cese-dci/tpfinal-dci-21b-Gonzagds/doc/propuesta/ESP PROG reverso.jpg

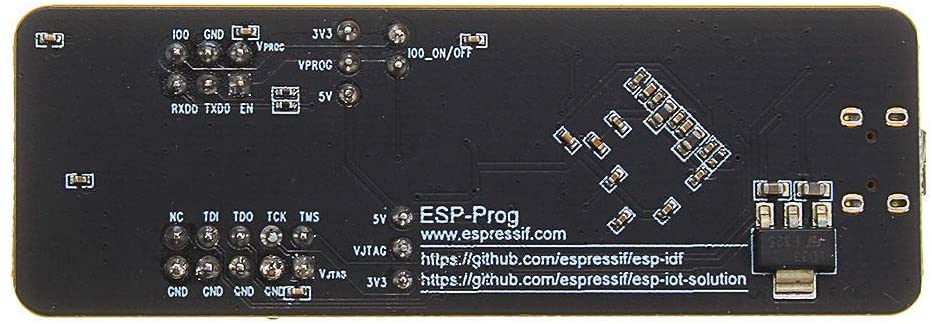
doc/propuesta/ESP PROG reverso.jpg
