cese-dci/tpfinal-dci-21b-Gonzagds/info/README.md

USB Interface IC USB HS to Dual UART/ FIFO/SPI/JTAG/I2C
http://www.ftdichip.com/Support/Documents/DataSheets/ICs/DS_FT2232H.pdf

Micro USB connector
https://ar.mouser.com/datasheet/2/670/uj2_mibh_g_smt_tr-2306717.pdf

Linear voltage regulator 3v3
http://www.st.com/st-web-ui/static/active/en/resource/technical/document/datasheet/CD00000544.pdf

Serial EEPROM Memory
http://www.st.com/st-web-ui/static/active/en/resource/technical/document/datasheet/CD00001142.pdf

Buffer driver
https://assets.nexperia.com/documents/data-sheet/74AHC_AHCT125.pdf

Inverting buffer
https://www.mouser.se/datasheet/2/308/mc74vhc1gt04-d-1193455.pdf

## Información complementaria ##
Para el alcance del TP solo es necesario colocar las hojas de datos más relevantes que se usaron en el diseño de PCB.
Pero el alumno puede completarlo tanto como desee.
