cese-dci/tpfinal-dci-21b-Gonzagds/doc/propuesta/README.md

https://docs.espressif.com/projects/espressif-esp-iot-solution/en/latest/hw-reference/ESP-Prog_guide.html

https://www.espressif.com/sites/default/files/documentation/ESP-Prog_V2.1_reference_design_r1.0.zip

https://media.digikey.com/pdf/Data%20Sheets/Espressif%20PDFs/Intro_to_the_ESP-Prog_Brd_Web.pdf

El Esp Prog es un grabador y debbuger para los devkit y modulos de la empresa Espressif. Se conecta a la PC mediante USB y cuenta con:
- Interfaz RS232 TTL para grabar la imagen y enviar y recibir mensajes de consola.
- Interfaz JTAG para debuggear paso a paso el programa.

## Propuesta ##
En este directorio debe ir OBLIGATORIAMENTE la información que se presentó al momento de acordar la propuesta de TP con el docente. Es decir:
* Fotos e imágenes de las placas de ambos lados si es una réplica. 
* Fotos e imágenes de los prototipos cableados o pruebas si es un trabajo de tesis.
* Urls o info de origen. 
* Circuito esquemático de referencia (si es una réplica) o borrador si es un trabajo de tesis.
* Resumen de la función u objetivo del circuito si es un trabajo de tesis.
* Cualquier otra nota que se haya usado para definir el TP en el formulario de propuesta.
