cese-dci/tpfinal-dci-21b-Gonzagds/doc/README.md

## Documentación ##
Para el alcance del TP solo es obligatorio completar el subdirectorio de "propuesta".
