cese-dci/tpfinal-dci-21b-Gonzagds/pcb/ESP-Prog.kicad_pcb

## KiCad design pcb/ESP-Prog.kicad_pcb (2021-08-21)

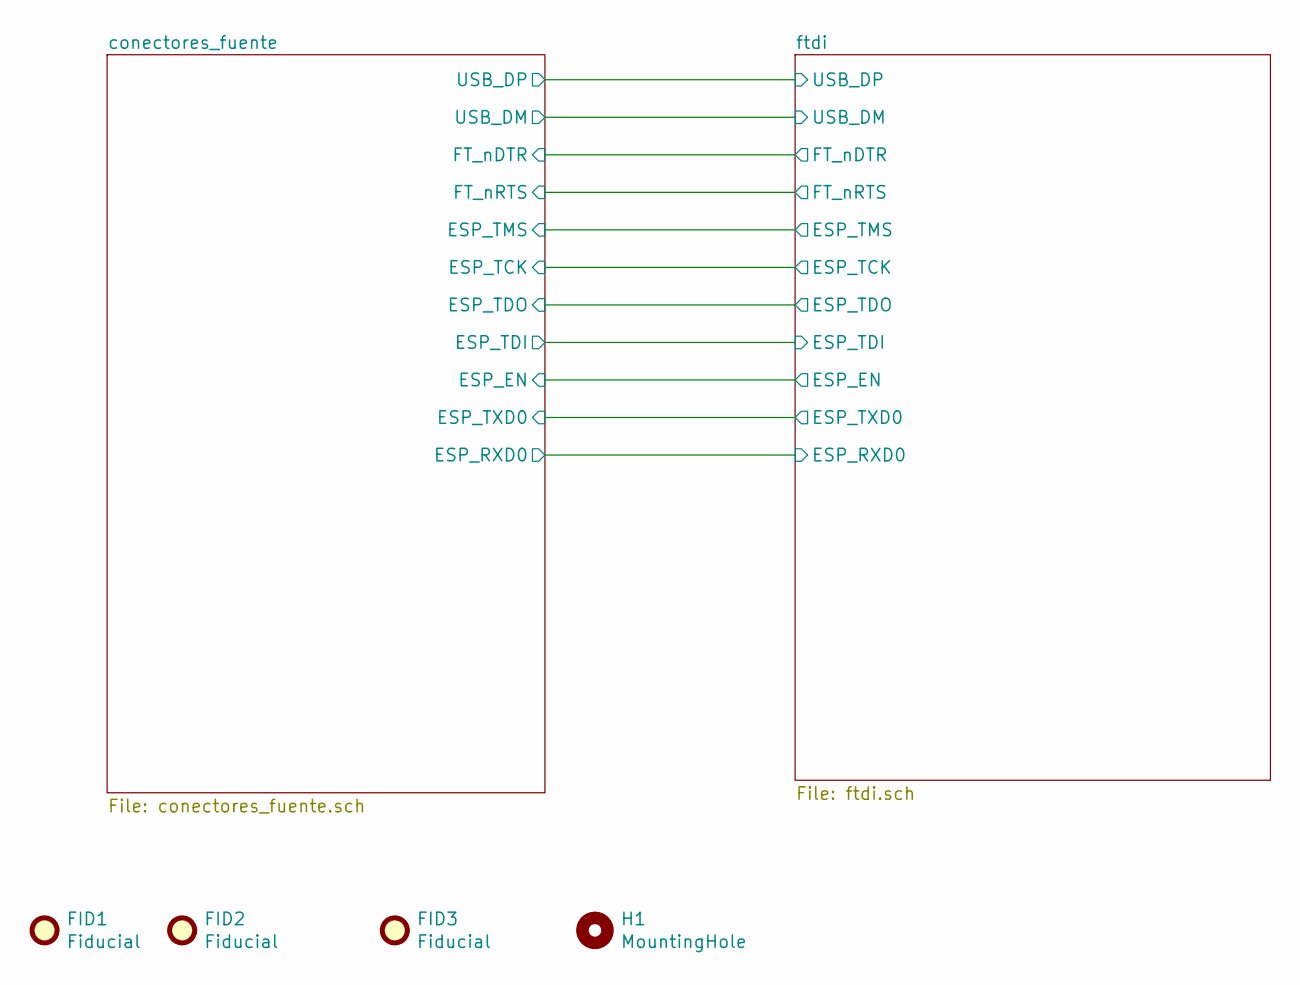
[picture p2: schematic ESP-Prog.sch, Espressif Programmer]

Parts:
FID1, FID2, FID3: Fiducial; Fiducial_0.5mm_Mask1mm
H1: MountingHole; MountingHole_2.5mm

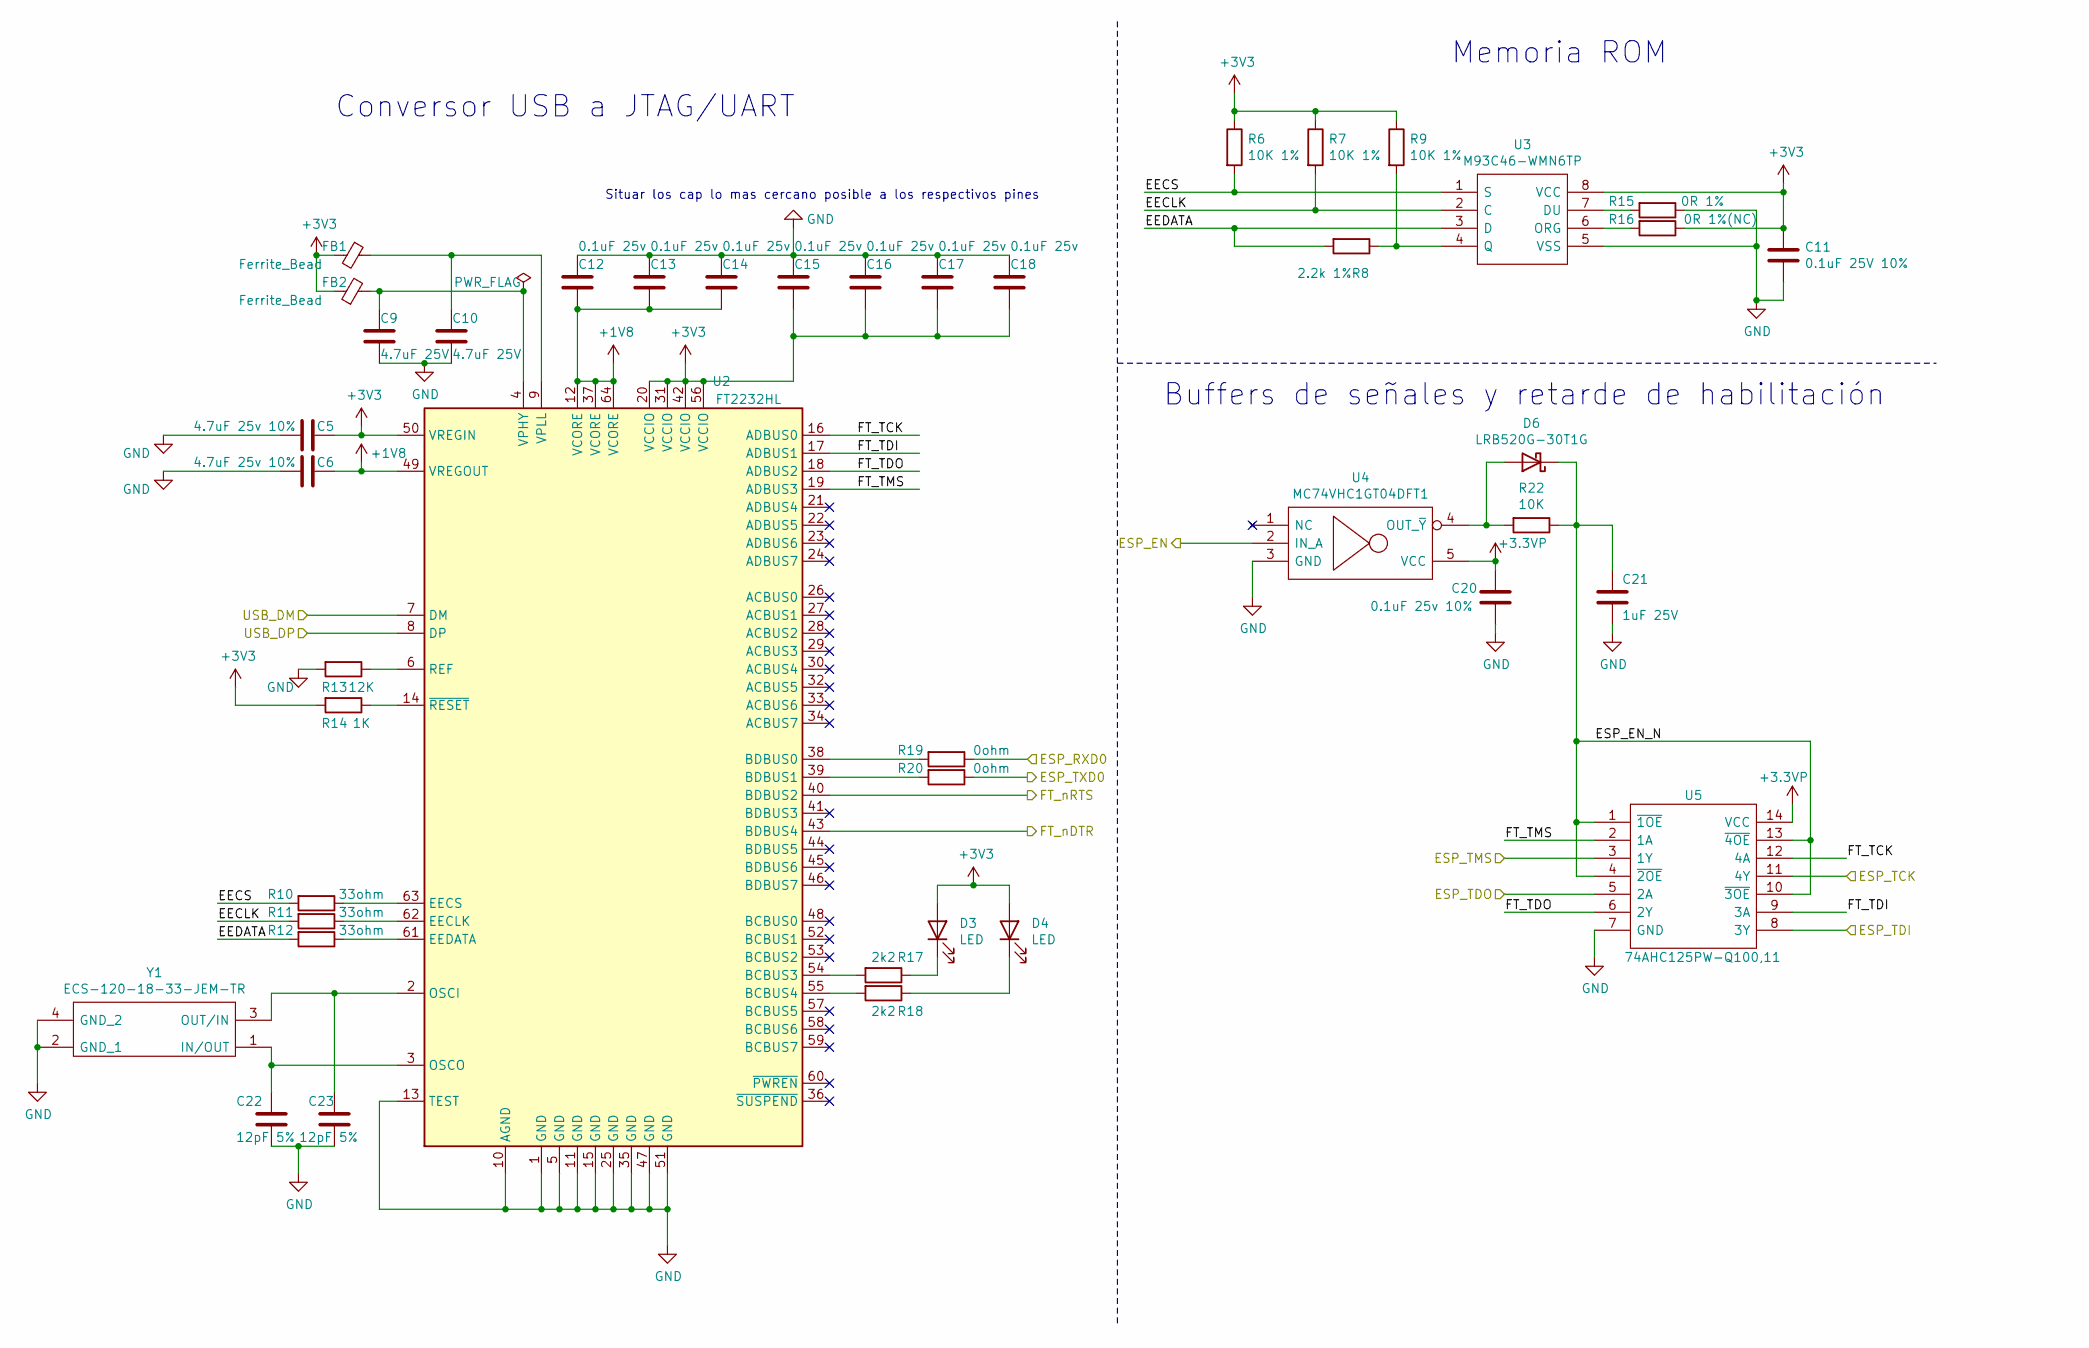
[picture p3: schematic ftdi.sch, Espressif Programmer]

Parts:
C5, C6: 4.7uF 25v 10%; C_0603_1608Metric
C9, C10: 4.7uF 25V; C_0603_1608Metric
C11: 0.1uF 25V 10%; C_0603_1608Metric
C12, C13, C14, C15, C16, C17, C18: 0.1uF 25v; C_0603_1608Metric
C20: 0.1uF 25v 10%; C_0603_1608Metric
C21: 1uF 25V; C_0603_1608Metric
C22, C23: 12pF 5%; C_0603_1608Metric
D3, D4: LED; LED_0603_1608Metric
D6: LRB520G-30T1G; D_0603_1608Metric
FB1, FB2: Ferrite_Bead; L_0603_1608Metric
R6, R7, R9: 10K 1%; R_0603_1608Metric
R8: 2.2k 1%; R_0603_1608Metric
R10, R11, R12: 33ohm; R_0603_1608Metric
R13: 12K; R_0603_1608Metric
R14: 1K; R_0603_1608Metric
R15: 0R 1%; R_0603_1608Metric
R16: 0R 1%(NC); R_0603_1608Metric
R17, R18: 2k2; R_0603_1608Metric
R19, R20: 0ohm; R_0603_1608Metric
R22: 10K; R_0603_1608Metric
U2: FT2232HL; LQFP-64_10x10mm_P0.5mm
U3: M93C46-WMN6TP; SOIC127P600X175-8N; Mouser Part Number 511-M93C46-WMN6TP
U4: MC74VHC1GT04DFT1; SOT65P210X110-5N; Mouser Part Number 863-MC74VHC1GT04DFT1
U5: 74AHC125PW-Q100,11; SOP65P640X110-14N; Mouser Part Number 771-74AHC125PWQ10011
Y1: ECS-120-18-33-JEM-TR; Crystal_SMD_0603-4Pin_6.0x3.5mm; Mouser Part Number 520-120-18-33-JEMT

Connections:
+1V8: C6.1, C12.2, C13.2, C14.2, U2.12 (VCORE), U2.37 (VCORE), U2.49 (VREGOUT), U2.64 (VCORE)
+3.3VP: C20.1, U4.5 (VCC), U5.14 (VCC); also elsewhere on the board
+3V3: C5.1, C11.1, C15.2, C16.2, C17.2, C18.2, D3.2 (A), D4.2 (A), FB1.2, FB2.1, R6.1, R7.1, R9.1, R14.2, R16.1, U2.20 (VCCIO), U2.31 (VCCIO), U2.42 (VCCIO), U2.50 (VREGIN), U2.56 (VCCIO), U3.8 (VCC); also elsewhere on the board
/conectores_fuente/ESP_EN: U4.2 (IN_A); also elsewhere on the board
/conectores_fuente/ESP_RXD0: R19.1; also elsewhere on the board
/conectores_fuente/ESP_TCK: U5.11 (4Y); also elsewhere on the board
/conectores_fuente/ESP_TDI: U5.8 (3Y); also elsewhere on the board
/conectores_fuente/ESP_TDO: U5.5 (2A); also elsewhere on the board
/conectores_fuente/ESP_TMS: U5.3 (1Y); also elsewhere on the board
/conectores_fuente/ESP_TXD0: R20.1; also elsewhere on the board
/conectores_fuente/FT_nDTR: U2.43 (BDBUS4); also elsewhere on the board
/conectores_fuente/FT_nRTS: U2.40 (BDBUS2); also elsewhere on the board
/conectores_fuente/USB_DM: U2.7 (DM); also elsewhere on the board
/conectores_fuente/USB_DP: U2.8 (DP); also elsewhere on the board
/ftdi/EECLK: R7.2, R11.2, U3.2 (C)
/ftdi/EECS: R6.2, R10.2, U3.1 (S)
/ftdi/EEDATA: R8.2, R12.2, U3.3 (D)
/ftdi/ESP_EN_N: C21.1, D6.1 (K), R22.1, U5.1 (~1OE), U5.4 (~2OE), U5.10 (~3OE), U5.13 (~4OE)
/ftdi/FT_TCK: U2.16 (ADBUS0), U5.12 (4A)
/ftdi/FT_TDI: U2.17 (ADBUS1), U5.9 (3A)
/ftdi/FT_TDO: U2.18 (ADBUS2), U5.6 (2Y)
/ftdi/FT_TMS: U2.19 (ADBUS3), U5.2 (1A)
GND: C5.2, C6.2, C9.2, C10.2, C11.2, C12.1, C13.1, C14.1, C15.1, C16.1, C17.1, C18.1, C20.2, C21.2, C22.2, C23.2, R13.2, R15.1, U2.1 (GND), U2.5 (GND), U2.10 (AGND), U2.11 (GND), U2.13 (TEST), U2.15 (GND), U2.25 (GND), U2.35 (GND), U2.47 (GND), U2.51 (GND), U3.5 (VSS), U4.3 (GND), U5.7 (GND), Y1.2 (GND_1), Y1.4 (GND_2); also elsewhere on the board
unnamed: C9.1, FB2.2, U2.4 (VPHY)
unnamed: C10.1, FB1.1, U2.9 (VPLL)
unnamed: C22.1, U2.3 (OSCO), Y1.1 (IN/OUT)
unnamed: C23.1, U2.2 (OSCI), Y1.3 (OUT/IN)
unnamed: D3.1 (K), R17.1
unnamed: D4.1 (K), R18.1
unnamed: D6.2 (A), R22.2, U4.4 (OUT_~Y)
unnamed: R8.1, R9.2, U3.4 (Q)
unnamed: R10.1, U2.63 (EECS)
unnamed: R11.1, U2.62 (EECLK)
unnamed: R12.1, U2.61 (EEDATA)
unnamed: R13.1, U2.6 (REF)
unnamed: R14.1, U2.14 (~RESET)
unnamed: R15.2, U3.7 (DU)
unnamed: R16.2, U3.6 (ORG)
unnamed: R17.2, U2.54 (BCBUS3)
unnamed: R18.2, U2.55 (BCBUS4)
unnamed: R19.2, U2.38 (BDBUS0)
unnamed: R20.2, U2.39 (BDBUS1)

Notes on the sheet:
Situar los cap lo mas cercano posible a los respectivos pines
Conversor USB a JTAG/UART
Memoria ROM
Buffers de señales y retarde de habilitación

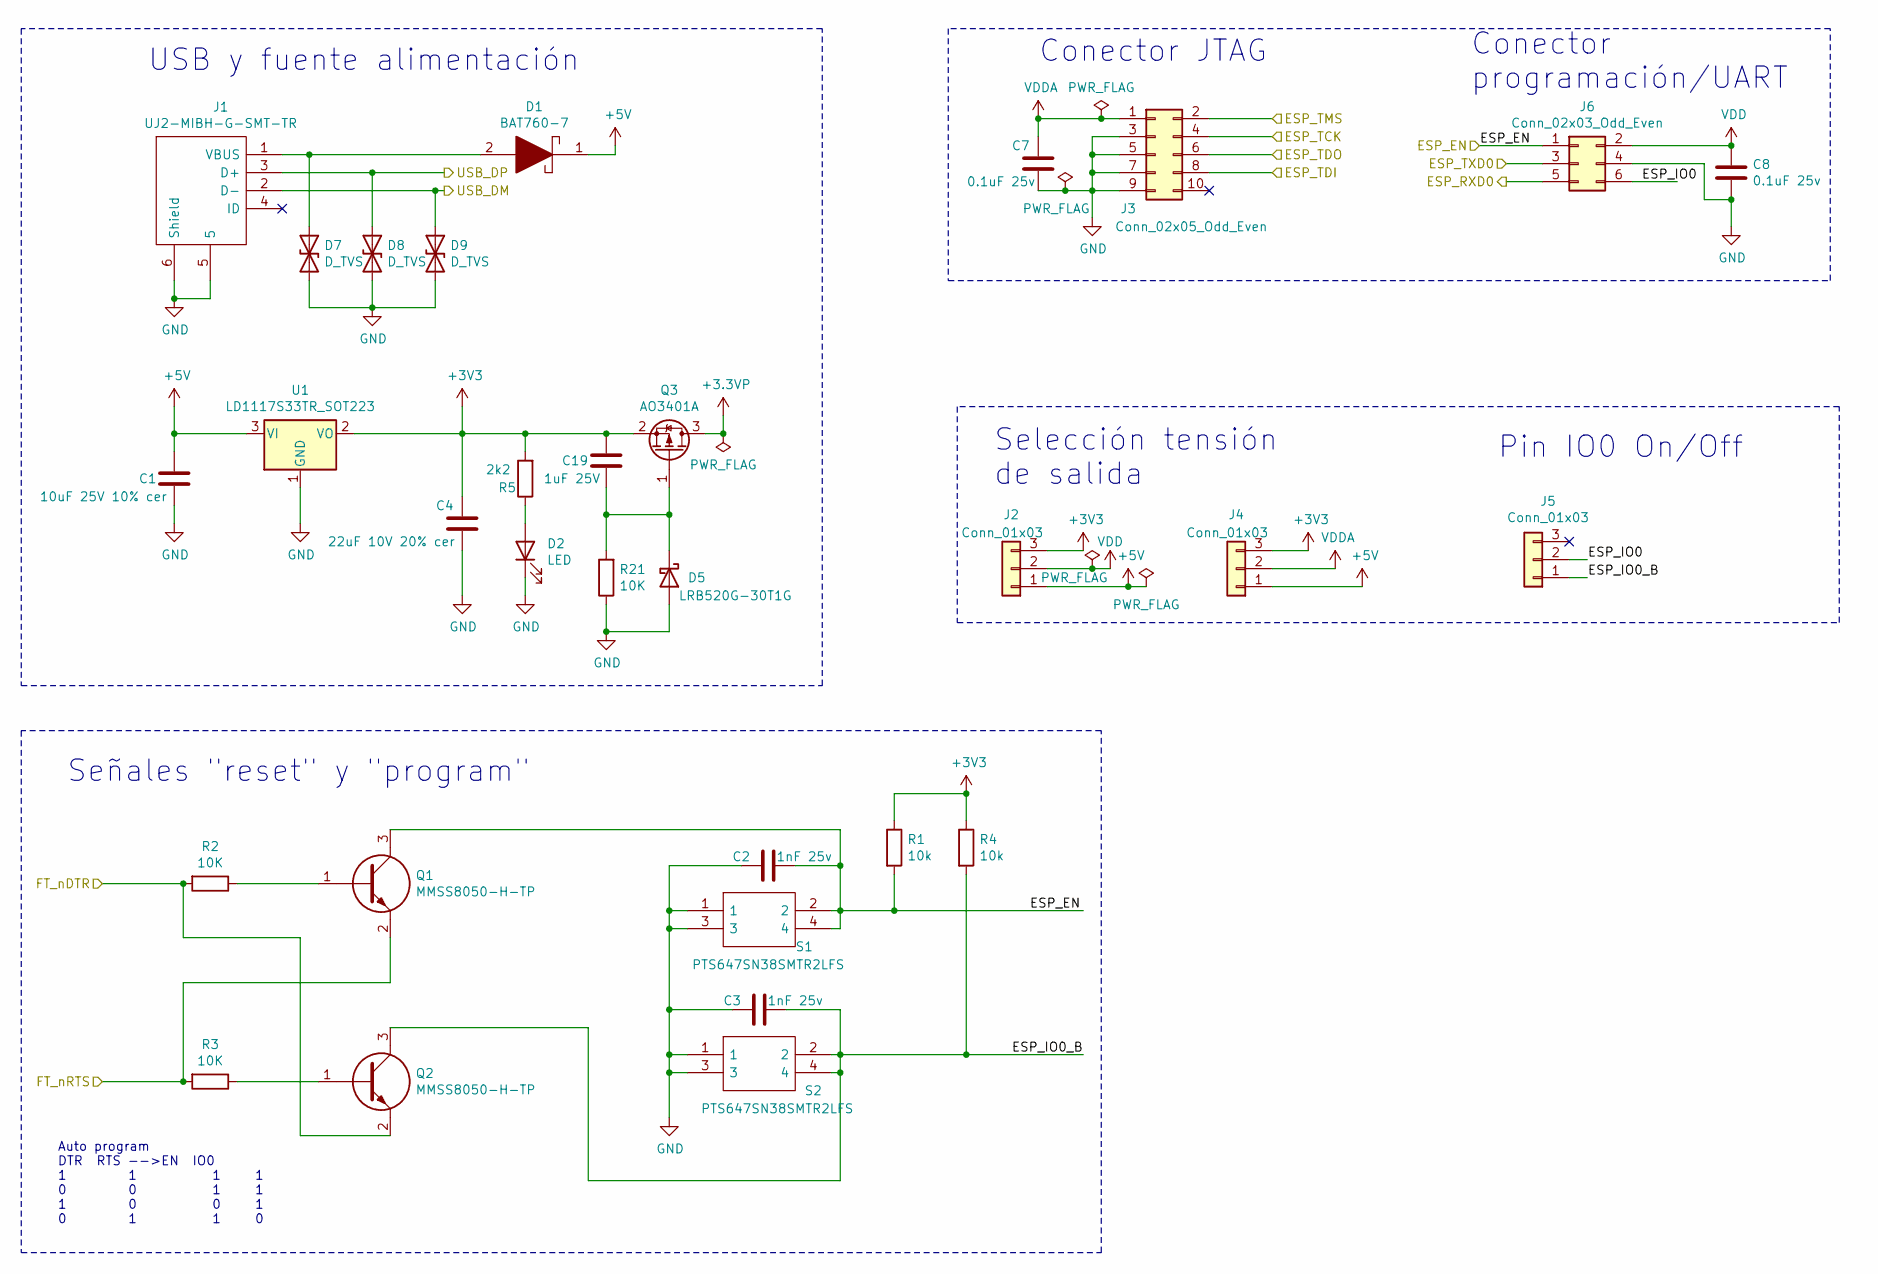
[picture p4: schematic conectores_fuente.sch]

Parts:
C1: 10uF 25V 10% cer; C_0603_1608Metric
C2, C3: 1nF 25v; C_0603_1608Metric
C4: 22uF 10V 20% cer; C_0603_1608Metric
C7, C8: 0.1uF 25v; C_0603_1608Metric
C19: 1uF 25V; C_0603_1608Metric
D1: BAT760-7; D_SOD-323; Mouser Part Number 621-BAT760-7
D2: LED; LED_0603_1608Metric
D5: LRB520G-30T1G; D_0603_1608Metric
D7, D8, D9: D_TVS; D_SOD-523
J1: UJ2-MIBH-G-SMT-TR; UJ2MIBHGSMTTR; Mouser Part Number 490-UJ2-MIBH-G-SMTTR
J2, J4, J5: Conn_01x03; PinHeader_1x03_P2.54mm_Vertical
J3: Conn_02x05_Odd_Even; PinHeader_2x05_P1.27mm_Vertical_SMD
J6: Conn_02x03_Odd_Even; PinHeader_2x03_P1.27mm_Vertical_SMD
Q1, Q2: MMSS8050-H-TP; SI2305TP; Mouser Part Number 833-MMSS8050-H-TP
Q3: AO3401A; SOT-23
R1, R4: 10k; R_0603_1608Metric
R2, R3, R21: 10K; R_0603_1608Metric
R5: 2k2; R_0603_1608Metric
S1, S2: PTS647SN38SMTR2LFS; PTS647SM38SMTR2LFS; Mouser Part Number 611-PTS647SN38SMTR2L
U1: LD1117S33TR_SOT223; SOT-223-3_TabPin2

Connections:
+3.3VP: Q3.3 (D); also elsewhere on the board
+3V3: C4.1, C19.1, J2.3, J4.3, Q3.2 (S), R1.1, R4.1, R5.2, U1.2 (VO); also elsewhere on the board
+5V: C1.1, D1.1, J2.1, J4.1, U1.3 (VI)
/conectores_fuente/ESP_EN: C2.1, J6.1, Q1.3, R1.2, S1.2, S1.4; also elsewhere on the board
/conectores_fuente/ESP_IO0: J5.2, J6.6
/conectores_fuente/ESP_IO0_B: C3.1, J5.1, Q2.3, R4.2, S2.2, S2.4
/conectores_fuente/ESP_RXD0: J6.5; also elsewhere on the board
/conectores_fuente/ESP_TCK: J3.4; also elsewhere on the board
/conectores_fuente/ESP_TDI: J3.8; also elsewhere on the board
/conectores_fuente/ESP_TDO: J3.6; also elsewhere on the board
/conectores_fuente/ESP_TMS: J3.2; also elsewhere on the board
/conectores_fuente/ESP_TXD0: J6.3; also elsewhere on the board
/conectores_fuente/FT_nDTR: Q2.2, R2.2; also elsewhere on the board
/conectores_fuente/FT_nRTS: Q1.2, R3.2; also elsewhere on the board
/conectores_fuente/USB_DM: D9.1 (A1), J1.2 (D-); also elsewhere on the board
/conectores_fuente/USB_DP: D8.1 (A1), J1.3 (D+); also elsewhere on the board
GND: C1.2, C2.2, C3.2, C4.2, C7.2, C8.2, D2.1 (K), D5.2 (A), D7.2 (A2), D8.2 (A2), D9.2 (A2), J1.5, J1.6 (Shield), J3.3, J3.5, J3.7, J3.9, J6.4, R21.1, S1.1, S1.3, S2.1, S2.3, U1.1 (GND); also elsewhere on the board
unnamed: C19.2, D5.1 (K), Q3.1 (G), R21.2
unnamed: D1.2, D7.1 (A1), J1.1 (VBUS)
unnamed: D2.2 (A), R5.1
unnamed: Q1.1, R2.1
unnamed: Q2.1, R3.1
VDD: C8.1, J2.2, J6.2
VDDA: C7.1, J3.1, J4.2

Notes on the sheet:
Auto program DTR RTS -->EN IO0 1 1 1 1 0 0 1 1 1 0 0 1 0 1 1 0
Conector JTAG
Conector programación/UART
Selección tensión de salida
Pin IO0 On/Off
USB y fuente alimentación
Señales "reset" y "program"

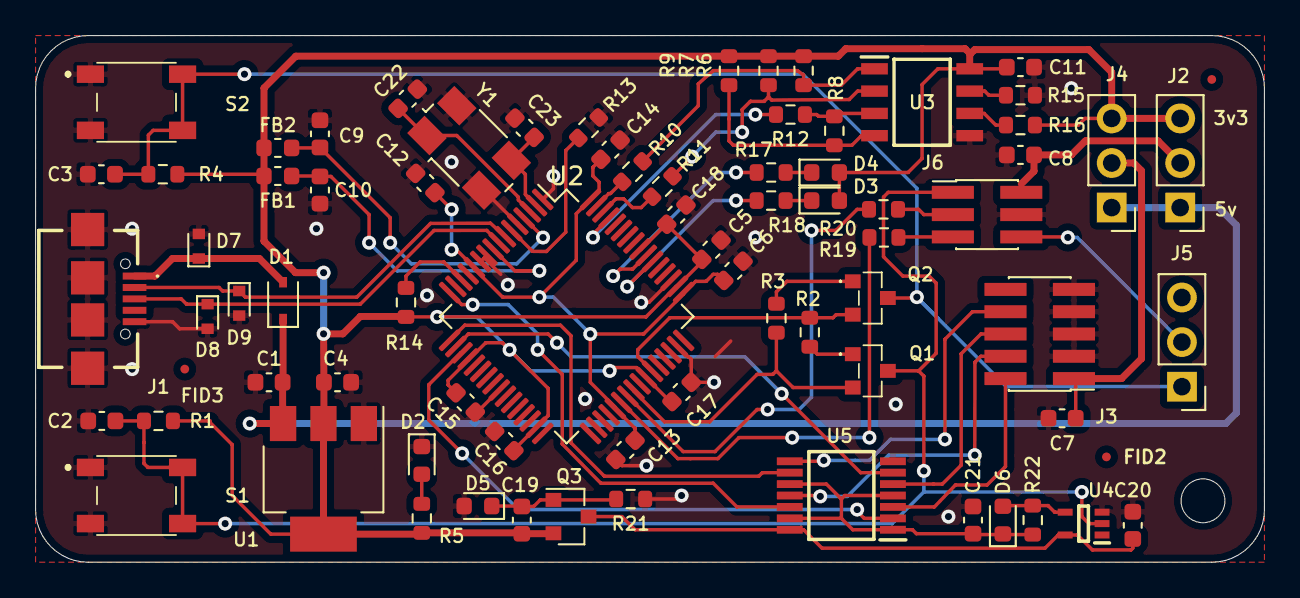
[picture p5: board ESP-Prog.kicad_pcb from above]

Board: 2 copper layers, 70.0 x 30.0 mm, 77 parts (0 on the bottom side), 52 nets.
