cese-dci/tpfinal-dci-21b-Gonzagds/(commit log)

2021-07-26 primer commit
    [ESP-Prog.kicad_pcb, ESP-Prog.sch, ftdi.sch]
2021-08-03 primer versión terminada del esquemático
    [ESP-Prog.sch, ftdi.sch]
2021-08-10 - se agregan todos los footprints
    [ESP-Prog.sch, ftdi.sch]
2021-08-14 - Se agregan hojas de datos e información del proyecto.
    [ESP-Prog.kicad_pcb, ESP-Prog.sch, ftdi.sch]
2021-08-15 se agrega información del proyecto, se completan archivos md y se agregan hojas de datos
    [ESP-Prog.kicad_pcb, ESP-Prog.sch, ftdi.sch]
2021-08-15 probando de commitear con token
    [ESP-Prog.kicad_pcb]
2021-08-15 correcciones al esquematico y avances en posicionamiento de pcb
    [ESP-Prog.kicad_pcb, ESP-Prog.sch, ftdi.sch]
2021-08-16 - Rpimer propuesta posicionamiento
    [ESP-Prog.kicad_pcb, ftdi.sch]
2021-08-16 - Se modifica el esquemático para respetar la estructura gerarquica
    [ESP-Prog.kicad_pcb, ESP-Prog.sch, conectores_fuente.sch, ftdi.sch]
2021-08-16 se agrega estructura gerarquica
    [conectores_fuente.sch]
2021-08-17 se agregan notas aclaratorias a los esquemáticos
    [conectores_fuente.sch, ftdi.sch]
2021-08-20 avances en el pcb y correcciones al esquematico
    [ESP-Prog.kicad_pcb, conectores_fuente.sch, ftdi.sch]
2021-08-21 Primer versión ruteo terminada
    [ESP-Prog.kicad_pcb, conectores_fuente.sch, ftdi.sch]
